mdj2812/intercom-button/docs/enclosure/README.zh-CN.md

# 桌面对讲按钮外壳

[English](README.md) | 简体中文

这是第一版可调参数的 OpenSCAD 外壳，适配：

- ESP32-S3-DevKitC-1（官方尺寸 62.74 × 25.40 mm）
- MAX9814 麦克风模块（PCB 25 × 14 mm，麦克风罐高 9 mm）
- 22 mm 面板安装自复位按钮

## 设计尺寸

- 外形：98 × 80 mm
- 前部高度：38 mm
- 后部高度：44 mm
- 顶面倾角：约 3.5°
- 壁厚：2.4 mm
- 顶板厚度：3.2 mm（按钮沉台下方保留 2.0 mm）
- 按钮开孔：Ø22.2 mm，外圈 Ø30.5 × 1.2 mm 沉台
- 上下壳定位及闭合：4 对 Ø6 × 2 mm 钕磁铁，无定位裙边
- ESP32 固定：半尺寸 82.5 × 55 × 8.5 mm 免焊面包板，使用自带背胶直接粘到底板
- Micro-USB 开口：两个 8.5 × 4.2 mm 独立开口，中间保留 4.2 mm 桥位

外壳采用上下分体结构。ESP32 安装在底壳右侧，USB 接口朝后；按钮位于左前方，以减少金属按钮对 ESP32 天线的影响。MAX9814 竖直安装在前面板后方，前面板有七孔拾音格栅。

## 生成 STL

三个 SCAD 文件需要放在同一目录：

- `intercom_button_base.scad`：底壳，按 `F6` 后导出 STL
- `intercom_button_lid.scad`：顶壳，按 `F6` 后导出 STL
- `intercom_button.scad`：共享参数、几何模块及装配预览

需要调整尺寸时只修改共享文件，底壳和顶壳会同时更新。

### 装配预览

使用 `part = "assembly"` 打开 `intercom_button.scad`。默认预览会显示半透明外壳，以及按尺寸简化的半尺寸面包板、ESP32-S3 开发板、WROOM 天线模块、排针、两个 Micro-USB 口、MAX9814 PCB 和麦克风罐、完整面板按钮。将 `show_components` 改为 `false` 可只查看不透明外壳。

### GitHub Actions 自动生成

`.github/workflows/enclosure-stl.yml` 会在外壳文件变更的 push、pull request 或手动触发时生成两个 STL，并上传为 `intercom-button-enclosure-stl` 构建产物。产物同时包含 `SHA256SUMS` 校验文件，保留 14 天。

## 推荐打印设置

- 材料：推荐 PETG；使用 PLA 时麦克风卡扣不适合反复拆装
- 喷嘴：0.4 mm
- 层高：0.20 mm
- 壁线：3 条
- 填充：15%–20%
- 底壳：底面朝下打印
- 顶壳：由切片软件自动选择朝向；按钮孔附近可使用局部支撑

## 装配

1. 先试放半尺寸面包板，确认位置后撕掉背膜，使用自带背胶直接粘到底壳。
2. 将 ESP32 插入面包板，使两个 Micro-USB 口对准后方开口。
3. 使用公头杜邦线把面包板上的 3.3V、GND、GPIO1 和 GPIO4 对应行连接到顶壳 JST 尾线。
4. 将 MAX9814 从顶壳下方向上推入滑轨，越过中间的加宽卡扣后自动锁定，使麦克风对准拾音孔；拆卸时轻推卡扣。
5. 将按钮穿过 22.2 mm 顶孔并用原配螺母锁紧。
6. 将 8 颗 Ø6 × 2 mm 钕磁铁试排并标记磁极方向。
7. 用环氧胶把磁铁粘入上下壳的 Ø6.2 × 2.2 mm 盲孔，确认每组磁铁相互吸引。
8. 胶水完全固化后合上外壳；拆卸时从 USB 开口处小心分离上下壳。

## 首次试装检查

不同厂商的兼容板可能与乐鑫原版有 1–3 mm 差异。正式打印前建议先核对：

- 开发板实际长宽及两个 USB 接口的总宽度
- 面包板尺寸和 ESP32 两排引脚的孔位对齐
- MAX9814 PCB 的实际尺寸和麦克风位置
- 按钮螺纹筒是否能通过 22.2 mm 测试孔
- 打印机的孔径和上下壳配合误差

尺寸来源：

- [乐鑫 ESP32-S3-DevKitC-1 官方尺寸图](https://dl.espressif.com/dl/PCB_ESP32-S3-DevKitC-1_V1_20210312CB.pdf)
- [Adafruit MAX9814 参考设计](https://www.adafruit.com/product/1713)（不同厂商 PCB 尺寸可能不同）
