mdj2812/intercom-button/docs/enclosure/BOM.md

# Desktop Intercom Button Bill of Materials

English | [简体中文](BOM.zh-CN.md)

## Required

- ESP32-S3-DevKitC-1 ×1
- Half-size solderless breadboard, approximately 82.5 × 55 × 8.5 mm ×1
- Male-to-male 2.54 mm jumper wires
- MAX9814 microphone module ×1
  - PCB: 25 × 14 mm
  - Microphone can height: approximately 9 mm
- 22 mm normally-open momentary push button ×1
  - Panel cutout: 22 mm
  - Outside diameter: no more than 29 mm
  - Behind-panel installation depth: no more than 19 mm
- Ø6 × 2 mm neodymium magnets ×8
- JST-PH 2.0 4-pin male/female cable set ×1
  - Conductors: 3.3V, GND, microphone OUT, and button signal
- 26–28 AWG flexible silicone wire
- Heat-shrink tubing
- Two-part epoxy ×1
- Micro-USB data/power cable ×1
- PETG-printed base and lid ×1 set

## Optional

- 1–2 mm open-cell foam for microphone isolation and dust protection
- 5V/1A USB power adapter
- Solder and flux

Use a small amount of two-part epoxy to secure the magnets. Confirm the polarity of every corresponding base/lid magnet pair before bonding them in place.
