mdj2812/intercom-button/docs/enclosure/BOM.zh-CN.md

# 桌面对讲按钮采购清单

[English](BOM.md) | 简体中文

## 必需物料

- ESP32-S3-DevKitC-1 ×1
- 半尺寸免焊面包板（约 82.5 × 55 × 8.5 mm）×1
- 2.54 mm 公对公杜邦线
- MAX9814 麦克风模块 ×1
  - PCB：25 × 14 mm
  - 麦克风罐高度：约 9 mm
- 22 mm 自复位常开按钮 ×1
  - 面板开孔：22 mm
  - 外径：不超过 29 mm
  - 面板后安装深度：不超过 19 mm
- Ø6 × 2 mm 钕磁铁 ×8
- JST-PH 2.0 4Pin 公母连接线 ×1 套
  - 线路：3.3V、GND、麦克风 OUT、按钮信号
- 26–28 AWG 软硅胶线 若干
- 热缩管 若干
- 双组分环氧胶 ×1
- Micro-USB 数据/供电线 ×1
- PETG 打印顶壳、底壳 ×1 套

## 可选物料

- 1–2 mm 开孔泡棉：用于麦克风隔振和防尘
- 5V/1A USB 电源适配器
- 焊锡和助焊剂

磁铁建议使用少量双组分环氧胶固定。粘接前先确认上下壳对应磁铁的极性，避免装反。
