mdj2812/intercom-button/docs/enclosure/intercom_button_base.scad

// Bottom shell export entry point.
// Keep this file beside intercom_button.scad.
render_part = "base";
include <intercom_button.scad>
