mdj2812/intercom-button/docs/enclosure/intercom_button_lid.scad

// Top shell export entry point.
// Keep this file beside intercom_button.scad.
render_part = "lid";
include <intercom_button.scad>
