mdj2812/intercom-button/src/consts.hpp

#pragma once
#include <cstdint>

/// Shared constants for esp32-intercom-button.
/// Single source of truth for magic numbers used across multiple modules.

// Maximum number of physical buttons supported
constexpr uint8_t MAX_BUTTONS = 8;

// Maximum length of a room key string (e.g. "study", "living")
constexpr uint8_t MAX_ROOM_KEY_LEN = 32;

// Maximum length of a server-assigned device name from hello
constexpr uint8_t MAX_DEVICE_NAME_LEN = 64;

/// Reported to the server in POST /devices/hello.
constexpr const char* FIRMWARE_VERSION = "0.3.1";

/// LAN HTTP path for server-cached firmware (GitHub assets are HTTPS-only).
constexpr const char* FIRMWARE_HTTP_PATH = "/api/home_intercom/firmware";

/// GET /api/home_intercom/config — global audio settings (#29), no auth.
constexpr const char* AUDIO_CONFIG_HTTP_PATH = "/api/home_intercom/config";

/// Compile-time audio fallbacks when GET /config (and hello) have not applied yet.
constexpr uint32_t AUDIO_SAMPLE_RATE_DEFAULT = 16000;
constexpr uint32_t AUDIO_MAX_RECORD_SECS_DEFAULT = 60;
constexpr uint32_t AUDIO_SAMPLE_RATE_MIN = 8000;
constexpr uint32_t AUDIO_SAMPLE_RATE_MAX = 48000;
constexpr uint32_t AUDIO_MAX_RECORD_SECS_MIN = 1;
constexpr uint32_t AUDIO_MAX_RECORD_SECS_MAX = 120;

/// Retry GET /config after a failed fetch (WiFi is up, server not ready yet).
constexpr unsigned long AUDIO_CONFIG_RETRY_MS = 5000;

/// After a failed flash, ignore hello `ota` until this elapses (or reboot).
constexpr unsigned long OTA_RETRY_SKIP_MS = 5 * 60 * 1000UL;

/// While pending OTA verify, retry hello this often until confirm or timeout.
constexpr unsigned long HELLO_OTA_CONFIRM_RETRY_MS = 2000;

/// Re-hello while idle so HA last_seen stays inside the 5-minute online window.
constexpr unsigned long HELLO_HEARTBEAT_MS = 10000;

/// Transient heartbeat failure (timeout / 5xx): stay registered, retry sooner.
constexpr unsigned long HELLO_HEARTBEAT_RETRY_MS = 30000;

/// Revoked (403): drop registration and retry on this interval until allowed again.
constexpr unsigned long HELLO_REVOKED_RETRY_MS = 30000;

/// While hello is pending approval: retry this often for HELLO_PENDING_BURST_MS.
constexpr unsigned long HELLO_PENDING_RETRY_MS = 200;

/// How long to poll aggressively after the first pending (then HELLO_PENDING_SLOW_MS).
constexpr unsigned long HELLO_PENDING_BURST_MS = 30000;

/// After the burst, keep waiting without using the 60s error cap.
constexpr unsigned long HELLO_PENDING_SLOW_MS = 5000;
