mdj2812/intercom-button/src/config_manager.h

#pragma once
#include <cstdint>

/// Runtime configuration loaded from LittleFS /config.json.
/// Call ConfigManager::begin() once in setup(), then use the accessors.
namespace ConfigManager {

/// Mount LittleFS and load config. Returns true on success.
/// Falls back to hardcoded defaults if file is missing or invalid.
bool begin();

// ── Accessors ────────────────────────────────────────
const char* wifi_ssid();
const char* wifi_password();
const char* server_scheme();
const char* server_host();
uint16_t server_port();

/// Active GPIO pins from config.json "pins" array.
/// Room targets come from hello ``buttons``; these pins are hardware-only.
const uint8_t* active_pins();
uint8_t active_pin_count();

} // namespace ConfigManager
