mdj2812/intercom-button/src/ota_keys.h

#pragma once
/**
 * @file ota_keys.h
 * @brief OTA firmware signing public key — secp256r1 ECDSA.
 *
 * The private key is NOT in the repo (stored as CI secret).
 * Generate a new key pair with: scripts/generate_ota_keys.sh
 */

#include <cstdint>

// secp256r1 (NIST P-256) ECDSA public key
// Format: uncompressed point (0x04 || X || Y), 65 bytes
static const uint8_t OTA_PUBLIC_KEY[] = {0x04, 0xac, 0xab, 0x64, 0xfc, 0xe7, 0x8d, 0x06, 0x5a, 0x1b, 0x8b, 0x21, 0x22,
                                         0xd0, 0xea, 0x4e, 0x76, 0x98, 0xeb, 0x86, 0xfb, 0x9c, 0xfd, 0xc3, 0xba, 0x64,
                                         0x25, 0x70, 0x5a, 0x0a, 0xf8, 0x55, 0xf0, 0x10, 0x89, 0xab, 0xe3, 0x07, 0x44,
                                         0xcf, 0x87, 0x66, 0xa8, 0x6e, 0xbc, 0x56, 0x02, 0xf1, 0x95, 0x8c, 0xe3, 0x6d,
                                         0xc8, 0xa4, 0x33, 0x15, 0x5b, 0x71, 0xaa, 0xa9, 0x86, 0xdf, 0xdc, 0x74, 0x92};
static constexpr size_t OTA_PUBLIC_KEY_LEN = 65;
