mdj2812/intercom-button/test/mocks/HTTPClient.h

#pragma once
#include "WString.h"
#include <Arduino.h>
#include <cstdint>
#include <cstdio>
#include <cstring>

// ── HTTP status ─────────────────────────────────────
#define HTTP_CODE_OK 200
#define HTTP_CODE_UNAUTHORIZED 401
#define HTTP_CODE_FORBIDDEN 403
#define HTTP_CODE_NOT_FOUND 404

// ── Mockable HTTP state ─────────────────────────────
struct HTTPMockState {
    int response_code = 200;
    std::string response_body = R"({"ok":true})";
    int connect_error = 0; // < 0 = connection error (timeout, reset)
    std::string last_url;
    std::string last_content_type;
    std::string last_auth_header;      // Authorization header value (if set)
    std::string last_device_id_header; // X-Device-ID header value (if set)
    std::string last_body;             // POST payload (JSON string posts)
    size_t last_body_size = 0;
    int post_call_count = 0;
    int get_call_count = 0;
};
inline HTTPMockState _http_mock;

inline void mock_http_reset() {
    _http_mock = HTTPMockState{};
}
inline void mock_http_set_response(int code, const std::string& body) {
    _http_mock.response_code = code;
    _http_mock.response_body = body;
    _http_mock.connect_error = 0;
}
inline void mock_http_set_error(int error_code) {
    _http_mock.connect_error = error_code;
}

// ── HTTPClient class ────────────────────────────────
class HTTPClient {
public:
    template <typename Client>
    bool begin(Client&, const char* url) {
        _http_mock.last_url = url ? url : "";
        return true;
    }

    void addHeader(const char* name, const char* value) {
        if (name && strcmp(name, "Content-Type") == 0)
            _http_mock.last_content_type = value ? value : "";
        if (name && strcmp(name, "Authorization") == 0)
            _http_mock.last_auth_header = value ? value : "";
        if (name && strcmp(name, "X-Device-ID") == 0)
            _http_mock.last_device_id_header = value ? value : "";
    }

    void setTimeout(uint32_t ms) {
        (void) ms;
    }

    int POST(uint8_t* data, size_t len) {
        (void) data;
        _http_mock.last_body.clear();
        _http_mock.last_body_size = len;
        _http_mock.post_call_count++;

        if (_http_mock.connect_error != 0)
            return _http_mock.connect_error;
        return _http_mock.response_code;
    }

    int POST(String payload) {
        _http_mock.last_body = payload.c_str();
        _http_mock.last_body_size = payload.length();
        _http_mock.post_call_count++;

        if (_http_mock.connect_error != 0)
            return _http_mock.connect_error;
        return _http_mock.response_code;
    }

    int GET() {
        _http_mock.last_body.clear();
        _http_mock.last_body_size = 0;
        _http_mock.get_call_count++;

        if (_http_mock.connect_error != 0)
            return _http_mock.connect_error;
        return _http_mock.response_code;
    }

    String getString() {
        return String(_http_mock.response_body);
    }

    String errorToString(int code) {
        char buf[64];
        snprintf(buf, sizeof(buf), "HTTP error %d", code);
        return String(buf);
    }

    void end() {}
};
