mdj2812/intercom-button/(commit log)

2026-06-15 feat: initial commit — ESP32-S3 desktop intercom button
    - Timer-driven ADC @ 16kHz mono PCM sampling
    - Push-to-talk with 300ms minimum recording threshold
    - WiFiManager with auto-reconnect
    - HTTP POST WAV to Flask /convert endpoint
    - WS2812 RGB LED status indicator
    - PSRAM buffer with DRAM fallback for 10s recording
    BOM: ESP32-S3-DevKitC + MAX9814 mic module + push button
2026-06-15 feat: Docker dev environment with pre-installed ESP32-S3 toolchain
    - ubuntu:22.04 + PlatformIO Core + espressif32 platform pre-cached
    - dev.sh: one-command interactive shell with auto USB device passthrough
    - .docker-image for version tracking
2026-06-15 fix: run as root for volume mount permission compatibility
2026-06-15 feat: working Docker dev environment with host toolchain mount
    - Dockerfile: ubuntu:22.04 + PlatformIO + ESP32 platform
    - dev.sh: auto-builds image, mounts host ~/.platformio for toolchains
    - Verified: pio run succeeds in container (33s, same as host)
2026-06-15 feat: self-contained Docker image (3GB) pushed to registry
    - Dockerfile copies host toolchains via --build-context
    - No host .platformio mount needed
    - dev.sh: tries local → pulls from registry.home.mdj2812.top
    - Image pushed: registry.home.mdj2812.top/esp32-pio-builder:v1.0.1
2026-06-15 docs: add README with wiring, commands, debugging guide
2026-06-15 fix: use study (rooms.json key) instead of Chinese name for ROOM_TARGET
    [config.h]
2026-06-15 fix: add upload_port + monitor_port for ESP32-S3 built-in USB (ttyACM0)
2026-06-15 fix: flash size 16MB→8MB (matches actual DevKitC-N8 hardware)
2026-06-15 fix: qio→dio flash mode (matches actual N8 hardware boot ROM)
2026-06-15 fix: HTTPClient timeout 30ms→60s + retry x3 + soft success on timeout
    - setTimeout was 30 milliseconds, not seconds (Arduino-ESP32 v3 API)
    - Now 60 seconds, retries 3 times with 1s delay
    - Connection errors treated as soft success — audio delivery > HTTP ack
    [http_uploader.cpp]
2026-06-15 feat: runtime config via LittleFS JSON instead of compile-time macros
    - ConfigManager loads wifi/server/room/audio settings from /config.json
    - Same firmware binary for all rooms — just upload different config per device
    - Pin definitions stay in config.h (compile-time, same for all)
    - AudioRecorder now accepts sample_rate + max_secs as params
    - Added ArduinoJson + LittleFS to platformio.ini
2026-06-15 docs: comprehensive README update + gitignore credentials
    - All config references updated from config.h → data/config.json
    - Added config.example.json template, gitignored real config
    - Debug log examples match actual runtime output
    - Troubleshooting table covers LittleFS upload issues
    - Dependencies include ArduinoJson
2026-06-15 ci: switch all jobs from docker-build to check runner
2026-06-15 ci: switch to container: syntax with v1.0.3 (includes node.js)
2026-06-15 ci: scope pio run/check to esp32-s3-devkitc-1 env
2026-06-15 fix: native env excludes src/ to avoid Arduino.h compile errors
2026-06-15 docs: switch README commands to make targets
2026-06-16 feat: add native test coverage pipeline
    - platformio.ini: native env uses --coverage + -O0 -g, unflags -Os -O2
    - extra_script.py: SCons hook injects -lgcov for linker ordering fix
    - Makefile: test-coverage target (lcov capture + genhtml)
    - Dockerfile: add lcov package
    - CI: new coverage job with artifact upload (uses v1.0.7 image)
    - .docker-image: bump to v1.0.7 (includes lcov)
    - .gitignore: add coverage/ output + data/config.json
    - CI triggers expanded to include Makefile and extra_script.py
    Verified: 6/6 tests pass, 96.4% lines coverage on native test code
    [extra_script.py]
2026-06-16 feat(mock): add Arduino.h mock header + smoke tests (Task 1)
    - test/mocks/: Arduino.h, WString.h, Print.h, Printable.h, Stream.h
    - All header-only with inline implementations (C++17 inline variables)
    - mock_set_millis/mock_advance_millis for test-controlled timing
    - Serial mock with printf via vprintf
    - test/test_mocks/: 5 smoke tests verifying mock compilation + behavior
    - platformio.ini: native env adds -Itest/mocks
2026-06-16 feat(mock): add LittleFS + File mock (Task 2)
    - test/mocks/FS.h: File class (inherits Stream, works with deserializeJson)
    - test/mocks/LittleFS.h: in-memory FS with inject() for test data
    - test/test_littlefs/: 3 tests (mount, inject+read, missing file)
    [FS.h, LittleFS.h, test_main.cpp]
2026-06-16 feat(mock): Tasks 3-6 — WiFi, HTTPClient mocks + real config_manager coverage
    - test/mocks/WiFi.h: mockable WiFi state (mock_wifi_set_connected, etc.)
    - test/mocks/HTTPClient.h: mockable HTTP (mock_http_set_response, etc.)
    - test/mocks/WString.h: add concat() for ArduinoJson compatibility
    - test/mocks/LittleFS.h: add reset() test helper
    - platformio.ini: test_build_src=yes, white-list src files, ARDUINOJSON_ENABLE_ARDUINO_STRING
    - build_src_filter: +config_manager, +wifi_manager, +http_uploader; -main, -audio_recorder
    - test/test_config_manager/: 4 integration tests passing through real ConfigManager
    - ArduinoJson converter fix: WiFi.h/HTTPClient.h include Arduino.h transitively
    All 18 te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
    [HTTPClient.h, WString.h, WiFi.h, test_main.cpp]
2026-06-16 feat(mock): Tasks 7-8 — wifi_manager + http_uploader real coverage
    - test/test_wifi_manager/: 7 tests (begin, update, retry interval, RSSI, status_str)
    - test/test_http_uploader/: 6 tests (success, retry, connection error, empty data, content-type)
    - WiFi.h/HTTPClient.h mocks: add transitive Arduino.h include
    - Makefile: filter /usr/* + test/mocks/* from coverage
    - platformio.ini: test_build_src=yes, ARDUINOJSON_ENABLE_ARDUINO_STRING
    Final src/ coverage: 98.9% lines, 98.4% functions across 4 source files
    config_manager: 91.5% | http_uploader: 96.4% | wifi_manager: 100% | wifi_manager.h: 100%
    [test_main.cpp]
2026-06-16 fix: clang-format all test files
    [test_main.cpp]
2026-06-16 fix: address PR review — unify Docker version, remove .hermes, simplify filter
    - CI: all jobs now use esp32-pio-builder:v1.0.7
    - .gitignore: add .hermes/ (plan files are local only)
    - platformio.ini: build_src_filter = +<*> -<main.cpp> -<audio_recorder.cpp>
2026-06-16 fix: read docker image from .docker-image; document exclusions
    - CI: load CI_IMAGE from docker/.docker-image via $GITHUB_ENV
    No more hardcoded version — bump .docker-image and CI follows.
    - platformio.ini: add inline comments explaining why main.cpp
    (NeoPixel) and audio_recorder.cpp (ESP hw_timer/ADC/heap) are excluded
2026-06-16 fix(ci): use ./docker/dev.sh instead of raw docker run
    dev.sh reads docker/.docker-image automatically — single source of truth
    for container image version. No more hardcoded image tag in CI.
2026-06-16 fix: address review — redundant -O2, mock_set_status helper, doc fix
    - platformio.ini: remove redundant -O2 from build_unflags (-O0 overrides it)
    - test/mocks/WiFi.h: add mock_wifi_set_status() helper
    - test_wifi_manager: use mock_wifi_set_status() instead of raw _wifi_mock.status
    - src/http_uploader.h: document soft-success behavior (returns true even after exhausted retries)
    [WiFi.h, http_uploader.h, test_main.cpp]
2026-06-17 feat(button): add ButtonManager with GPIO debounce and native tests
    - ButtonManager class: N-button GPIO matrix with per-button debounce (50ms)
    - Detects PRESS, RELEASE, and LONG_PRESS (2s) events via poll()
    - is_held() and hold_duration() for recording state tracking
    - 10 native tests covering: init, debounce, bounce filtering,
    release, long press (single-fire), hold duration, independent buttons
    - Enhanced test/mocks/Arduino.h: test-controllable digitalRead pin state
    and pinMode tracking (digitalReadPin[], pinModePinParam[])
    Closes #9
2026-06-17 fix(button): add destructor, clang-format compliance
    - Added ~ButtonManager() destructor to free _buttons array
    - Applied clang-format to button_manager.h/.cpp and test file
    - All 43 tests still pass
    [button_manager.cpp, button_manager.h, test_main.cpp]
2026-06-17 refactor(button): replace poll-based debounce with GPIO interrupts
    Previously poll() called digitalRead() on every button every loop
    iteration — constantly occupying the core even when idle.
    Now each button attaches a CHANGE interrupt via attachInterruptArg().
    The ISR records the level + timestamp; poll() only inspects the ISR
    queue. When no buttons are pressed, poll() returns NONE in O(1) with
    zero GPIO reads.
    - Button struct: irq_pending / irq_time / irq_level (volatile, ISR-updated)
    - _isr() static trampoline with IRAM_ATTR
    - Debounce flag cleared AFTER debounce window, not before
    - _simulate_change() for native testability
    - Native tests: replaced set_pin() with _simulate_change() ca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
    [Arduino.h, button_manager.cpp, button_manager.h, test_main.cpp]
2026-06-17 fix(review): address PR #16 review comments
    - delete copy ctor/assignment, add default ctor (=default)
    - guard begin() against re-init (leak + orphaned ISRs)
    - wrap _simulate_change() in #ifdef UNIT_TEST
    - add snapshot race comment in poll()
    - add NONE sentinel comment
    - test: placement-new instead of copy-assignment
    - test: remove unused <cstring>, add <new>
    - platformio.ini: add -DUNIT_TEST for native env
    Review: #47 (homelab_bot), #48 (hephaestus)
    [button_manager.cpp, button_manager.h, test_main.cpp]
2026-06-17 refactor(button): replace raw Button* with std::unique_ptr<Button[]>
    - unique_ptr auto-frees allocation in destructor
    - begin() uses .reset() instead of manual delete[]
    - No functional change — all 41 tests pass
    [button_manager.cpp, button_manager.h]
2026-06-17 refactor(button): unique_ptr → std::vector, remove _count member
    vector is a better fit — handles allocation, sizing, and ownership.
    Eliminates the separate _count member (use .size() instead).
2026-06-17 feat: per-button ROOM_TARGET via NVS (RoomTargetStore)
    - RoomTargetStore: NVS-backed room mapping per GPIO pin
    - Key format: btn_<gpio> → room key (e.g. btn_4 → study)
    - Falls back to compiled-in defaults when NVS key missing
    - Mock Preferences.h for native testing
    - main.cpp integrated: ButtonManager + RoomTargetStore replaces
    single-button digitalRead loop
    - 9 new tests, 50 total pass
    Closes #10
    [Preferences.h, config.h, main.cpp, room_target_store.cpp, room_target_store.h, test_main.cpp]
2026-06-17 feat: add config.json buttons field as Tier 2 fallback
    Priority chain: NVS → config.json → hardcoded defaults.
    - RoomTargetStore: set_default_room() / clear_defaults() / defaults_count()
    - ConfigManager: parses 'buttons' JSON object, load_button_defaults()
    - data/config.example.json: added buttons mapping
    - 4 new tests for config-file defaults tier
    54 tests pass (50 + 4).
2026-06-17 fix(review): address PR #19 review comments
    #464: LONG_PRESS for PTT (avoid accidental triggers)
    #465: Document no data race (single-threaded loop)
    #466: std::vector<DefaultEntry> replacing fixed array
    #462: Configurable pins via config.json "pins" field
    #463: JSON_DOC_SIZE as named constant
    - Removed compile-time BUTTON_PINS from config.h
    - ConfigManager::button_pins() / button_pin_count() accessors
    - config.example.json now includes "pins" array
    54 tests pass.
    [config.h, config_manager.cpp, config_manager.h, main.cpp, room_target_store.cpp, room_target_store.h]
2026-06-17 fix(review): address PR #19 review comments (round 2)
    #474: DefaultEntry::room uses std::string (no char[32])
    #472: Remove duplicate defaults from ConfigManager, fallback to config.h BUTTON_PINS
    #471: Add comment explaining JSON_DOC_SIZE calculation
    #470: Warn on pins/buttons size mismatch in config.json
    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
    [config.h, config_manager.cpp, main.cpp, room_target_store.cpp, room_target_store.h]
2026-06-17 fix(review): address PR #19 review comments (round 3)
    #480: Create src/consts.hpp for MAX_BUTTONS (single source of truth)
    #478: JSON_DOC_SIZE as calculated constexpr (JSON_BASE + MAX_BUTTONS*JSON_PER_BTN)
    #479: Revert to PRESS (2s LONG_PRESS too long for PTT)
    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
    [config_manager.cpp, consts.hpp, main.cpp, room_target_store.cpp, room_target_store.h]
2026-06-17 fix: #474 — replace _room_buf[32] with std::string _room_cache
    - static char _room_buf[32] → static std::string _room_cache
    - strncpy → simple assignment
    - No more raw char buffer management
    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
    [room_target_store.cpp]
2026-06-17 fix(review): #474 — std::string return for get_room(), remove static _room_cache
    [main.cpp, room_target_store.cpp, room_target_store.h, test_main.cpp]
2026-06-17 fix(review): #486 std::string params, #487 drop snprintf for std::to_string
    [config_manager.cpp, room_target_store.cpp, room_target_store.h]
2026-06-17 fix(review): #490 — declare JSON key strings as constexpr constants
    [config_manager.cpp]
2026-06-17 style: clang-format alignment fix for JSON key constants
    [config_manager.cpp]
2026-06-17 fix(review): address PR #19 homelab_bot suggestions
    - MAX_ROOM_KEY_LEN: add truncation + warning in set_room() (was defined but unused)
    - config.example.json: document pins vs buttons field relationship
    - Rename button_pins() → active_pins() / button_pin_count() → active_pin_count()
    - RoomTargetStore::begin(): clarify it's a one-shot NVS health check
    54/54 tests pass.
    [config_manager.cpp, config_manager.h, main.cpp, room_target_store.cpp, room_target_store.h]
2026-06-17 style: clang-format — include order + fprintf indentation
2026-06-18 fix(main): ignore second button press while recording (#20)
    When a button is pressed during active recording on another button,
    flash LED red for 150ms and ignore the event. This implements
    option 5 from the simultaneous multi-button press policy:
    LED feedback + ignore, which is the simplest safe behavior.
    Closes #20
    [main.cpp]
2026-06-18 fix(room_store): guard getString with isKey to suppress NVS noise
    ESP32 Preferences::getString() logs ERROR when key does not exist,
    even when a default value is provided. Check isKey() first to avoid
    the misleading '[E] nvs_get_str len fail: btn_X NOT_FOUND' log on
    first boot when no NVS keys have been written yet.
    Also add isKey() to the mock Preferences for native tests.
    [Preferences.h, room_target_store.cpp]
2026-06-28 refactor: snprintf -> std::format_to_n + bump to C++20
    - src/http_uploader.cpp: replace snprintf with std::format_to_n
    Uses {} placeholders instead of printf %s/%u specifiers
    - platformio.ini: -std=c++17 -> c++20 (native) + -std=gnu++20 (ESP32)
    Required for <format> header support
    - All 55 native tests pass
    [http_uploader.cpp]
2026-06-28 refactor: snprintf -> std::ostringstream for URL construction
    fmtlib/fmt has ABI incompatibility on ESP32 toolchain.
    std::ostringstream is standard C++11, zero-dependency, type-safe,
    and avoids printf format-string issues.
    No -std flag needed on ESP32.
    [http_uploader.cpp]
2026-06-28 feat(ota): custom partition table with factory + ota_0 + ota_1 for OTA support (#3)
    - partitions_ota_8MB.csv: factory(2MB) + ota_0(2MB) + ota_1(2MB) + littlefs(1.9MB)
    - platformio.ini: switch from default_8MB.csv to custom partition table
    - Firmware fits comfortably: 55.1% of 2MB slot (0.9MB headroom for OTA code)
    [partitions_ota_8MB.csv]
2026-06-28 feat(ota): HTTP firmware download and flash to inactive OTA slot (#4)
    - ota_manager: HTTP streaming download via WiFiClient, writes to Update partition
    - SHA-256 incremental verification against X-Checksum-SHA256 response header
    - Progress reporting (bytes, percent) via serial every 2s during download
    - Serial-triggered: type 'ota' to start update, 'reboot' to restart
    - LED feedback: orange during OTA, green/red flash on success/failure
    - Flash overhead: +9KB (55.1% → 55.6% of 2MB slot)
    [main.cpp, ota_manager.cpp, ota_manager.h]
2026-06-28 feat(ota): ECDSA signature verification for OTA firmware (#5)
    - ECDSA secp256r1 (NIST P-256) signature verification via mbedtls
    - Public key embedded as compile-time constant in ota_keys.h
    - Device downloads firmware.bin.sig alongside firmware.bin
    - Signs SHA-256 hash of firmware binary, verifies before Update.end()
    - scripts/sign_firmware.py — sign firmware with OpenSSL ECDSA
    - scripts/generate_ota_keys.sh — generate new key pair
    - Private key (.pem) is git-ignored, stored as CI secret
    - Graceful fallback: no .sig file → skip verification (dev mode)
    - Flash overhead: +1.8KB (55.6% → 55.7%)
    [ota_keys.h, ota_manager.cpp]
2026-06-28 feat(ota): rollback mechanism with boot confirmation (#6)
    - ESP32 bootloader auto-rollback via pending_verify state
    - 60s confirmation window after OTA reboot (LED fast-blinks orange)
    - Confirm via button press or serial 'confirm' command
    - NVS tracks consecutive boot failures (max 3 → auto-reject image)
    - Timeout or 3+ failures → ESP.restart() → bootloader rolls back
    - confirm_boot() marks image valid + resets failure counter
    - Flash overhead: +0.2KB (55.7%)
    [main.cpp, ota_manager.cpp, ota_manager.h]
2026-07-10 docs: public release — GitHub CI, README.zh-CN, audit pass
    - Add .github/workflows/ci.yml (setup-platformio, no private deps)
    - Add README.zh-CN.md (full Chinese translation)
    - Update README.md: rename to Intercom Button, GitHub links, updated structure
    - Add scripts/ota_private.pem to .gitignore
    - Change docker/.docker-image to local-only name
    - Remove internal registry references from dev.sh
2026-07-10 ci: add release workflow — build firmware and attach to release
2026-07-10 fix(ota): truncate leading zeros in DER→raw signature conversion
    ECDSA signatures from OpenSSL DER may have r or s > 32 bytes
    due to leading zero padding. Truncate to exactly 32 bytes each
    for the 64-byte raw r||s format expected by mbedtls.
2026-07-10 fix(ota): rename LittleFS partition from 'littlefs' to 'spiffs'
    Arduino LittleFS.begin() searches for partition named 'spiffs' by default.
    The CSV subtype 'spiffs' was correct, but the partition name must also match.
    [partitions_ota_8MB.csv]
2026-07-10 fix(ota): correct firmware URL path to /esp32-intercom-button.bin
    [ota_manager.cpp]
2026-07-10 fix: correct onboard LED GPIO from 48 to 38
    ESP32-S3-DevKitC onboard WS2812 is on GPIO38, not GPIO48.
    [config.h]
2026-07-10 fix(ota): explicitly set boot partition after flash + add partition debug log
    Update.end() writes firmware but does not automatically set the boot partition
    in Arduino-ESP32 v3.x. Add esp_ota_set_boot_partition() to switch to the new
    OTA slot before rebooting.
    Also add debug logging to show current partition state at boot.
    [main.cpp, ota_manager.cpp]
2026-07-10 fix(ota): add esp_ota_ops.h include for partition debug log
    [main.cpp]
2026-07-10 fix(ota): set boot partition before Update.end(); improve state debug log
    [main.cpp, ota_manager.cpp]
2026-07-10 fix(ota): grab target partition before Update.begin() claims it
    esp_ota_get_next_update_partition() returns NULL once Update.begin()
    has selected the partition. Save the pointer early and pass it to
    esp_ota_set_boot_partition() before Update.end().
    [ota_manager.cpp]
2026-07-10 fix(ota): set boot partition AFTER Update.end() (needs valid image in partition)
    [ota_manager.cpp]
2026-07-10 fix(ota): use NVS flag instead of ota state for boot confirmation
    esp_ota_set_boot_partition() sets boot preference but bootloader
    never auto-sets PENDING_VERIFY on ESP32-S3. Use an NVS boolean
    'pending' flag instead — set before reboot, checked on next boot,
    cleared on user confirmation.
    [ota_manager.cpp]
2026-07-10 fix(ota): proper rollback via esp_ota_mark_app_invalid_rollback()
    - Expose increment_failure() and mark_invalid_and_rollback()
    - On confirmation timeout: increment failure count, restart
    - After MAX_BOOT_FAILURES (3) timeouts: mark image invalid → bootloader rolls back
    - During boot: if too many failures, mark invalid immediately
    [main.cpp, ota_manager.cpp, ota_manager.h]
2026-07-10 fix(ota): clear stale NVS OTA flags when booting factory
    [main.cpp]
2026-07-10 fix: add Preferences.h include in main.cpp
    [main.cpp]
2026-07-10 refactor: extract LED blink patterns into led_blink_n()
    - Add led_blink_n(r,g,b,count,interval) for fixed-count blink sequences
    - Replace inline for-loop blinks in OTA, UPLOAD, CONFIRM states
    - Fix clang-format: separate local/system includes, alphabetical
    [main.cpp]
2026-07-10 refactor: use named LED color constants instead of inline RGB tuples
    Define C_OFF, C_GREEN, C_RED, C_BLUE, C_ORANGE, C_WHITE as constexpr LED structs.
    Update led_set(), led_blink(), led_blink_n() to accept const LED&.
2026-07-10 fix(ota): rewrite sig download body reader for HTTP/1.0
    HTTP/1.0 servers close the connection after sending response,
    causing sig_client.connected() to return false before the 64-byte
    body can be read via the available()+read loop. Replace with
    a simple time-bounded read loop.
    [ota_manager.cpp]
2026-07-10 fix: gate main serial handler to avoid consuming confirm in CONFIRMING state
    The main loop's Serial.available() check ran in ALL states, consuming
    the 'confirm' command before the CONFIRMING state's own handler could
    process it. Gate to skip in CONFIRMING and OTA states.
    [main.cpp]
2026-07-13 feat(docker): push dev image to ghcr.io, add docker-build workflow
    - Change .docker-image from local tag to ghcr.io/mdj2812/intercom-button-dev:latest
    - Add workflow that pre-downloads PlatformIO toolchains on runner,
    injects them via --build-context, and pushes the self-contained ~3GB image
    - Trigger: push to main on Dockerfile/.docker-image changes, or manual dispatch
    - dev.sh unchanged: tries local first, then pulls from ghcr (public, no login needed)
2026-07-13 feat: adapt to unified /api/home_intercom/record API with HA auth token
    - Switch URL from /record to /api/home_intercom/record (works with both
    Docker Flask alias and HA integration HomeAssistantView)
    - Add ha_token config field: empty = no auth header (Docker compat),
    non-empty = Authorization: Bearer header sent with POST
    - Default server_port changed from 8764 to 8123 (HA default)
    - Update config.json and config.example.json with new fields
    - Add 3 new tests: auth header with token, without token, with nullptr
    Closes #23
2026-07-15 fix(docker): dev.sh pulls image from registry, never builds locally without -b
    Previously dev.sh fell through to local docker build when the image
    was not found locally. Now it:
    - Tries local → tries ghcr.io pull → fails with clear error
    - Only builds locally when -b flag is passed
    - Removes 2>/dev/null on pull so errors are visible
2026-07-16 feat: support authenticated HTTPS device uploads
2026-07-16 Cleanup config
    remove redundant config entries and merge pins and buttons
2026-07-16 test: update test_config_manager to use ha_token instead of removed room_target
    ConfigManager::room_target() was removed as room mapping moves
    to server-side. Tests now use ha_token() accessor for all
    partial-config / invalid-JSON / missing-file scenarios.
    [test_main.cpp]
2026-07-16 fix: address code review — unified endpoint, defaults, minor fixes
    - Remove /device/record path — server only has /api/home_intercom/record.
    Use same URL for both auth and non-auth; Authorization header distinguishes.
    - Fix indexOf > 0 to >= 0 (misses {ok:true} without leading whitespace)
    - Add HTTPS cert-not-verified warning to serial log
    - Update compile-time defaults to 192.168.99.4:8123 (match README)
    - Add UTF-8 comment for octal escapes in test (homelab-bot feedback)
    Closes review feedback from hephaestus-bot and homelab-bot on PR #27.
    [config_manager.cpp, http_uploader.cpp, http_uploader.h, test_main.cpp]
2026-07-16 docs: add buttons mapping to README config examples, fix stale refs
    - Add 'buttons' field to config example in both EN and CN READMEs
    - Add buttons/sample_rate/max_record_secs to field description table
    - Fix stale /device/record endpoint mentions (removed in code)
    - Fix stale 'room' in multi-button setup instructions
    - Update debug log example to match current config_manager output
2026-07-16 fix(ci): switch release trigger from published to tag push
    The release was created by the bot App, but CI's GITHUB_TOKEN
    cannot update resources owned by a different integration.
    Now the workflow triggers on 'v*' tag push and creates the release
    itself — CI owns the release and can attach artifacts.
2026-07-23 feat: add parametric enclosure design
    Establish a printable checkpoint for magnetic closure and component retention.
    [intercom_button.scad, intercom_button_base.scad, intercom_button_lid.scad]
2026-07-23 feat: refine enclosure fit and add BOM
    Align the USB and antenna clearances with the physical board and document required hardware.
    [intercom_button.scad]
2026-07-23 ci: generate enclosure STLs and add English docs
    Publish reproducible enclosure artifacts and keep assembly and procurement guidance bilingual.
2026-07-23 feat: add dimensioned enclosure assembly preview
    Model the installed hardware for clearance checks and strengthen the microphone retention while keeping STL entry points self-contained.
    [intercom_button.scad, intercom_button_base.scad, intercom_button_lid.scad]
2026-07-23 feat: mount ESP32 on a perfboard carrier
    Replace fragile printed board clips with a serviceable socketed carrier that simplifies wiring and assembly.
    [intercom_button.scad]
2026-07-23 fix: size enclosure for Micro-USB ports
    Match the physical DevKit connectors across the model and documentation while keeping the BOM focused on required purchases.
    [intercom_button.scad]
2026-07-23 feat: mount ESP32 on a solderless breadboard
    Simplify first-build assembly by replacing the perfboard carrier with an adhesive half-size breadboard.
    [intercom_button.scad]
2026-07-23 fix: keep microphone wiring clear of latch
    Replace the two edge latches with one wider central retainer so both soldered ends remain accessible.
    [intercom_button.scad]
2026-09-09 feat: identify the device by MAC instead of an HA token
    Uploads and OTA send X-Device-ID to /device/record so the ESP32 no longer stores or transmits a Home Assistant long-lived access token.
    [HTTPClient.h, WString.h, WiFi.h, config_manager.cpp, config_manager.h, device_id.cpp, device_id.h, http_uploader.cpp]
2026-09-09 feat: register the device with POST /devices/hello on connect
    Trust-on-first-use hello after WiFi so the MAC is in the server registry before any upload. Recording waits behind that handshake, with backoff on failure.
    [HTTPClient.h, consts.hpp, device_hello.cpp, device_hello.h, main.cpp, test_main.cpp]
2026-09-09 feat: send idle hello every 10 seconds
    Shorten the heartbeat so HA last_seen refreshes faster during testing; revoked retry stays at 60s.
    [consts.hpp]
2026-09-09 refactor: name hello device_name and room buffer sizes
    Replace the 64/32 array lengths with MAX_DEVICE_NAME_LEN and MAX_ROOM_KEY_LEN.
    [consts.hpp, device_hello.h]
2026-09-09 fix: attach a TTY for docker-monitor and pin PlatformIO 6.2.0
    pio device monitor needs a real terminal for miniterm; pin Core so the
    dev image rebuilds to a known version instead of staying on 6.1.19.
2026-09-09 feat: map buttons from GET /rooms after hello
    Stop logging hello's empty room field; print GPIO targets only once
    the catalog is fetched. Pins stay local; buttons remain an offline fallback.
2026-09-09 fix: restore hello timeout and pending backoff
    The fetch-rooms commit accidentally included pairing long-poll firmware
    (30s timeout, 200ms pending retry). Revert those; room mapping is unchanged.
    [consts.hpp, device_hello.cpp, main.cpp]
2026-09-09 fix: blink orange during pending hello and drop IRAM_ATTR clash
    Pending retries stay aggressive for 30s instead of ramping to 60s. The
    pairing LED runs on a side task so blocking HTTP still flashes. Stub
    IRAM_ATTR only in the ISR TU so WiFi/FreeRTOS can define the real one.
    [button_manager.cpp, button_manager.h, consts.hpp, main.cpp]
2026-09-09 fix: retry revoked hello every 30 seconds
    Keep the 60s cap for transient registration errors; a 403 should poll again on the same interval as a heartbeat blip.
    [consts.hpp, main.cpp]
2026-09-09 feat: drop buttons from config; rooms come from the server
    Keep pins as the hardware GPIO list. Ignore a leftover buttons object so old config.json files still load.
2026-09-09 release: bump to v0.2.0
    Report 0.2.0 on hello and cut the changelog so the tag-triggered release notes start at this version.
2026-09-09 fix(ci): publish only the tagged version in GitHub release notes
    The release workflow was attaching the entire CHANGELOG.md, so v0.2.0 included 0.1.0 and 0.0.1.
2026-09-09 fix: use the mounted USB node for docker monitor and flash
    Stop hardcoding ttyACM0 so a board that enumerates as ttyACM1 can be monitored and flashed.
2026-09-09 feat: enter OTA when hello returns ota:true
    Download from /api/home_intercom/firmware instead of a static bin path, and
    attach a 64-byte .sig on GitHub releases when OTA_PRIVATE_KEY is set.
2026-09-09 release: bump to v0.2.1
    Report 0.2.1 on hello and cut changelog notes so the tag-triggered
    release can publish the signed LAN OTA firmware.
2026-09-10 feat: confirm OTA boot via hello instead of a 60s button press
    Unattended panels mark a new image valid when /devices/hello parses
    ok/pending/revoked. Serial confirm_test dry-runs that window without
    rollback.
2026-09-10 ci: run confirm_test on the reserved Gitea ESP32
    Gitea workflow_dispatch flashes factory on butler-runner and dry-runs
    OTA confirm over serial. GitHub CI stays cloud-only.
2026-09-10 ci: run Gitea HIL on main push after mirror sync
    Keep workflow_dispatch for a manual run; path filters avoid flashing the
    board for docs-only updates.
2026-09-10 fix(hil): strip CR from esptool MAC before comparing the reserved board
    Gitea logs showed a false mismatch of the same address; esptool emits CR.
2026-09-10 release: bump to v0.2.2
    Report 0.2.2 on hello and cut changelog notes so the tag-triggered
    release can publish signed firmware that confirms OTA via hello.
2026-09-10 feat: send hello pins and apply a buttons map
    Advertise GPIOs so the PWA can bind rooms from GET /media_players.
    When hello includes buttons, write them to NVS and skip GET /rooms
    order. Also match X-Checksum-Sha256 from Waitress.
    [device_hello.cpp, device_hello.h, main.cpp, ota_manager.cpp, room_target_store.h, test_main.cpp]
2026-09-10 feat: refresh GPIO room map on idle hello
    PWA add/edit/delete was invisible until reboot because heartbeat skipped
    GET /rooms. Unassign leftover pins so a deleted room does not keep a
    stale NVS target.
    [main.cpp, room_target_store.cpp, room_target_store.h, test_main.cpp]
2026-09-10 feat: treat empty hello buttons as keep NVS
    Home Intercom #78 always sends a buttons object. Empty {} is unconfigured
    and must not fall back to GET /rooms catalog order. HIL checks the map
    after LAN OTA.
2026-09-10 feat: drop GET /rooms client and catalog pin mapping
    Room targets come only from hello buttons. Keep optional config.json
    pins for hardware GPIOs that differ from the compiled default.
2026-09-10 fix: mock String::concat for hello pins JSON
    Native tests compile device_hello.cpp; Arduino concat(char) and
    concat(unsigned) were missing on the host String mock.
    [WString.h]
2026-09-10 feat: bake PIO libs into the dev image and split HIL jobs
    HIL compile was fetching scons, NeoPixel, ArduinoJson, and Unity on every run. Install them globally in the image and run compile, flash, and test as separate Gitea jobs.
2026-09-10 feat: fetch sample_rate and max_record_secs from GET /config
    Audio settings come from the server after WiFi (#29). Leftover keys in
    config.json are ignored; offline boot keeps 16000 Hz / 60 s.
2026-09-10 refactor: keep server audio settings in RAM, not LittleFS Config
    sample_rate and max_record_secs come from GET /config, so Config stays wifi/server/pins only.
2026-09-10 fix: retry GET /config if audio reconfigure fails
    Do not mark server audio applied when recorder.configure() fails, and free the PCM buffer if timerBegin fails after alloc.
    [audio_recorder.cpp, main.cpp]
2026-09-10 release: bump to v0.3.0
    Report 0.3.0 on hello and cut changelog notes so the tag-triggered
    release can publish signed firmware with hello buttons and server audio.
2026-09-11 fix(hil): reserve DC:DA:0C:61:9C:B8 as the USB board
    Gitea HIL and local hil_run.sh refuse any other MAC; the previous default was the old panel.
2026-09-11 fix: keep signed OTA off the loop stack and hold HIL ota until dry-run
    ECDSA verify plus a 4KB download buffer overflowed the 8KB loopTask. 9C:B8
    still had ota_requested, so hello started a signed GitHub flash during
    confirm_test (the other board never hit .sig because HIL plants unsigned).
    [main.cpp, ota_manager.cpp]
2026-09-11 ci(hil): take host settings from Gitea Actions variables
    Reserved MAC, NAS SSH, and related HIL paths are repo variables so a board
    swap does not need a firmware commit. Script defaults remain for local butler runs.
2026-09-11 ci(hil): drop lab defaults from the HIL script and examples
    Board MAC, LAN addresses, and SSH user live in Gitea variables; missing env fails the job.
    [config_manager.cpp]
2026-09-11 chore: generate compile_commands.json for host clangd from Docker
    Copy firmware PIO packages out of the image so local clangd can resolve Arduino and ESP-IDF headers.
    [extra_script.py]
2026-09-11 ci(hil): sign planted OTA and reject tampered sig/checksum (#46)
    HIL now flashes only a GitHub-key-signed branch image; a wrong SHA header
    and a wrong .sig must fail on the board before hello-confirm.
2026-09-11 release: bump to v0.3.1
    Report 0.3.1 on hello and cut changelog notes so the tag-triggered
    release can publish signed firmware with the signed-OTA stack fix.
    [consts.hpp]
